BatteryMaximus/Dock-PCB/SingleCharger/SingleCharger.kicad_pcb

## KiCad design SingleCharger/SingleCharger.kicad_pcb (2025-04-10)

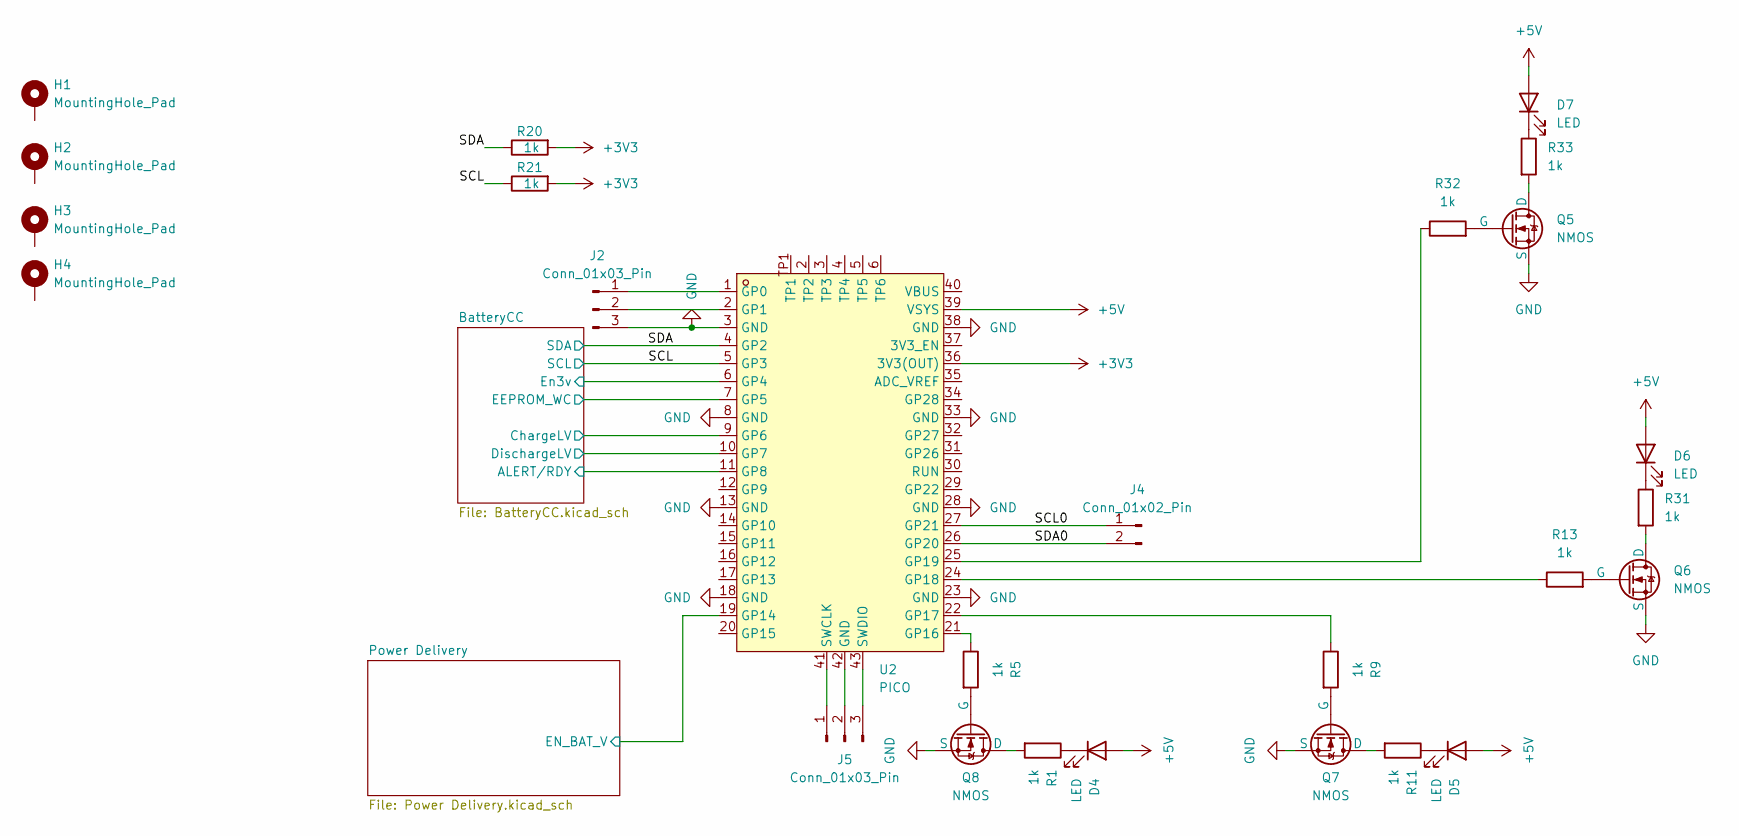
[picture p1: schematic SingleCharger.kicad_sch]

Parts:
D4, D5, D6, D7: LED; LED_1206_3216Metric
H1, H2, H3, H4: MountingHole_Pad; MountingHole_3.2mm_M3_DIN965_Pad_TopBottom
J2, J5: Conn_01x03_Pin; PinHeader_1x03_P2.54mm_Horizontal
J4: Conn_01x02_Pin; PinHeader_1x02_P2.54mm_Horizontal
Q5, Q6, Q7, Q8: NMOS; SOT-23
R1, R5, R9, R11, R13, R20, R21, R31, R32, R33: 1k; R_1206_3216Metric
U2: PICO; RaspberryPi_Pico_SMD; LCSC Part C7203002

Connections:
+3V3: R20.2, R21.2, U2.36 (3V3(OUT)); also elsewhere on the board
+5V: D4.2 (A), D5.2 (A), D6.2 (A), D7.2 (A), U2.39 (VSYS); also elsewhere on the board
/BatteryCC/ALERT/RDY: U2.11 (GP8); also elsewhere on the board
/BatteryCC/Battery/EEPROM_WC: U2.7 (GP5); also elsewhere on the board
/BatteryCC/ChargeLV: U2.9 (GP6); also elsewhere on the board
/DischargeLV: U2.10 (GP7)
/En3v: U2.6 (GP4)
/Power Delivery/EN_BAT_V: U2.19 (GP14); also elsewhere on the board
/SCL: R21.1, U2.5 (GP3); also elsewhere on the board
/SCL0: J4.1, U2.27 (GP21)
/SDA: R20.1, U2.4 (GP2); also elsewhere on the board
/SDA0: J4.2, U2.26 (GP20)
GND: J2.3, Q5.2 (S), Q6.2 (S), Q7.2 (S), Q8.2 (S), U2.3 (GND), U2.8 (GND), U2.13 (GND), U2.18 (GND), U2.23 (GND), U2.28 (GND), U2.33 (GND), U2.38 (GND); also elsewhere on the board
unnamed: D4.1 (K), R1.1
unnamed: D5.1 (K), R11.1
unnamed: D6.1 (K), R31.1
unnamed: D7.1 (K), R33.1
unnamed: J2.1, U2.1 (GP0)
unnamed: J2.2, U2.2 (GP1)
unnamed: J5.1, U2.41 (SWCLK)
unnamed: J5.2, U2.42 (GND)
unnamed: J5.3, U2.43 (SWDIO)
unnamed: Q5.3 (D), R33.2
unnamed: Q5.1 (G), R32.2
unnamed: Q6.3 (D), R31.2
unnamed: Q6.1 (G), R13.2
unnamed: Q7.3 (D), R11.2
unnamed: Q7.1 (G), R9.2
unnamed: Q8.3 (D), R1.2
unnamed: Q8.1 (G), R5.2
unnamed: R5.1, U2.21 (GP16)
unnamed: R9.1, U2.22 (GP17)
unnamed: R13.1, U2.24 (GP18)
unnamed: R32.1, U2.25 (GP19)

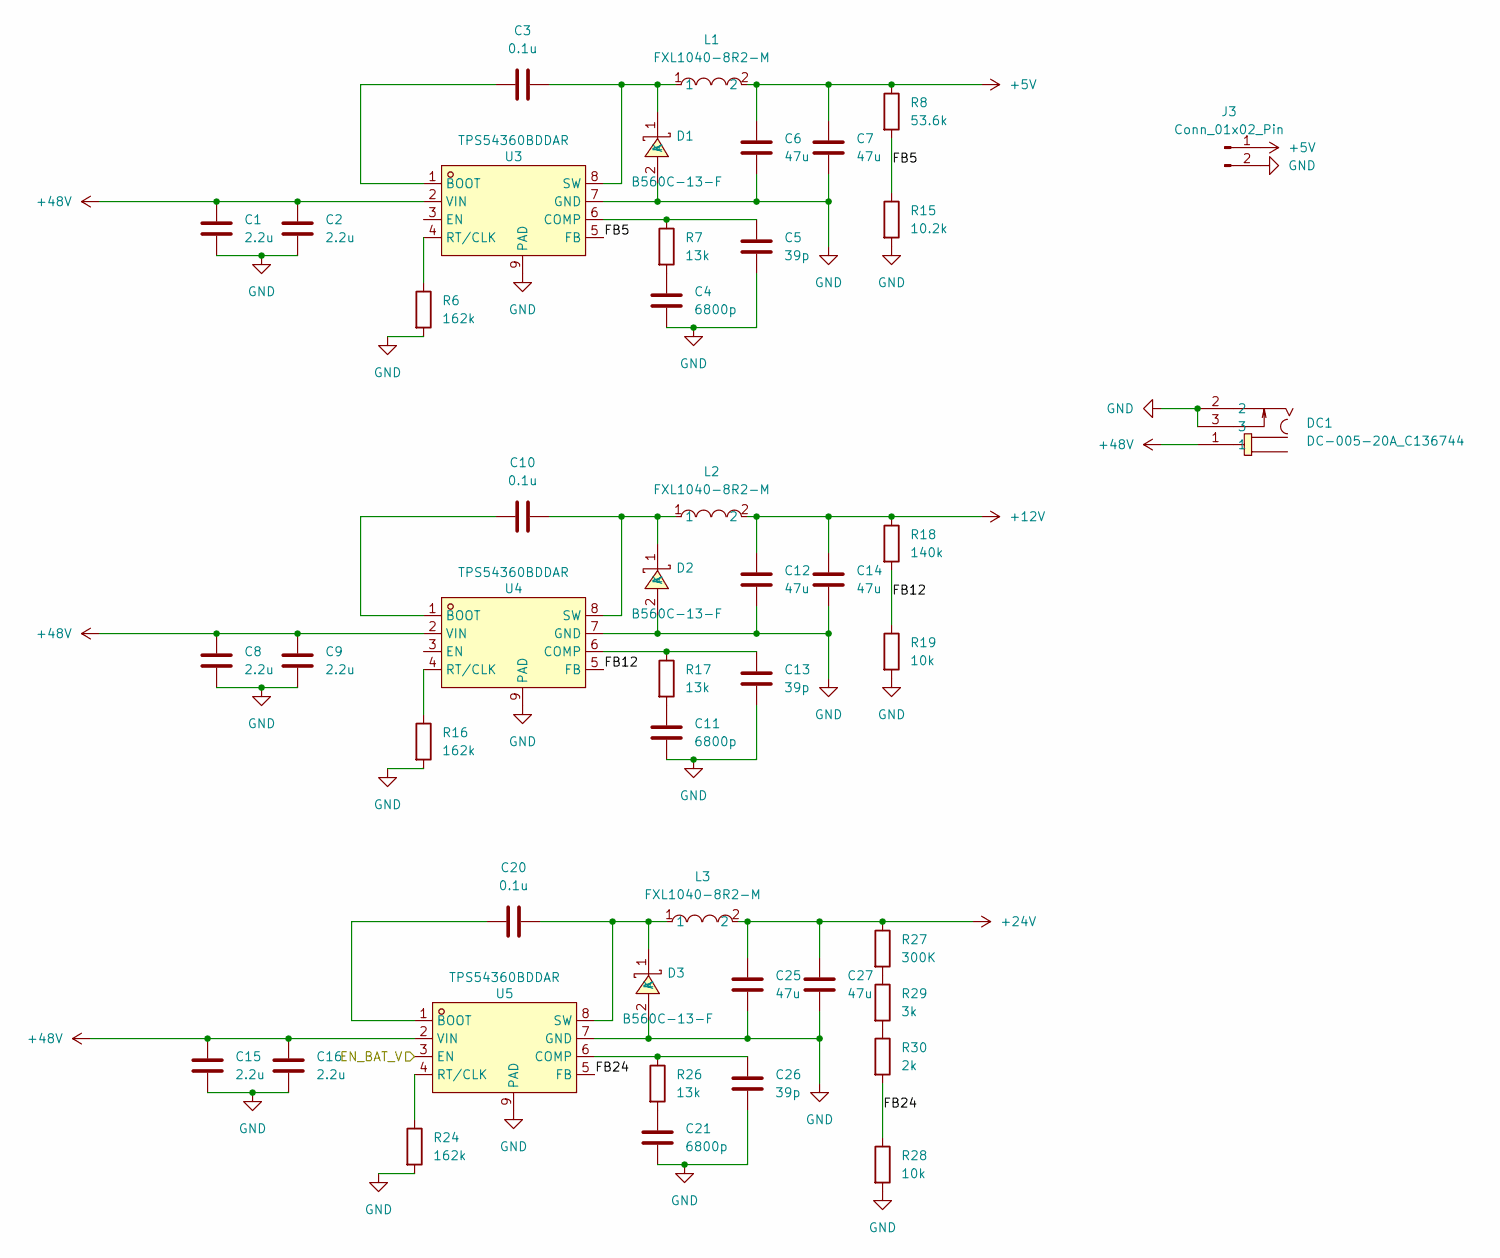
[picture p2: schematic Power Delivery.kicad_sch]

Parts:
C1, C2, C8, C9, C15, C16: 2.2u; C_1206_3216Metric; LCSC Part C170101
C3, C10, C20: 0.1u; C_1206_3216Metric; LCSC Part C56392
C4, C11, C21: 6800p; C_1206_3216Metric; LCSC Part C2760541
C5, C13, C26: 39p; C_1206_3216Metric; LCSC Part C5186878
C6, C7, C12, C14, C25, C27: 47u; C_1206_3216Metric; LCSC Part C94034
D1, D2, D3: B560C-13-F; SMC_L7.1-W6.2-LS8.1-RD; LCSC Part C85100
DC1: DC-005-20A_C136744; DC-IN-TH_DC-005-20A; LCSC Part C136744
J3: Conn_01x02_Pin; PinHeader_1x02_P2.54mm_Horizontal
L1, L2, L3: FXL1040-8R2-M; IND-SMD_L11.5-W10.0_FXL1040; LCSC Part C167232
R6, R16, R24: 162k; R_1206_3216Metric_Pad1.30x1.75mm_HandSolder; LCSC Part C22815
R7, R17, R26: 13k; R_1206_3216Metric_Pad1.30x1.75mm_HandSolder; LCSC Part C445658
R8: 53.6k; R_1206_3216Metric_Pad1.30x1.75mm_HandSolder; LCSC Part C21398
R15: 10.2k; R_1206_3216Metric_Pad1.30x1.75mm_HandSolder; LCSC Part C21398
R18: 140k; R_1206_3216Metric_Pad1.30x1.75mm_HandSolder; LCSC Part C21398
R19, R28: 10k; R_1206_3216Metric_Pad1.30x1.75mm_HandSolder; LCSC Part C21398
R27: 300K; R_1206_3216Metric_Pad1.30x1.75mm_HandSolder; LCSC Part C21398
R29: 3k; R_1206_3216Metric_Pad1.30x1.75mm_HandSolder; LCSC Part C21398
R30: 2k; R_1206_3216Metric_Pad1.30x1.75mm_HandSolder; LCSC Part C21398
U3, U4, U5: TPS54360BDDAR; SOIC-8_L5.0-W4.0-P1.27-LS6.0-BL-EP2.0; LCSC Part C524806

Connections:
+5V: C6.1, C7.1, J3.1, L1.2, R8.1; also elsewhere on the board
+12V: C12.1, C14.1, L2.2, R18.1; also elsewhere on the board
+24V: C25.1, C27.1, L3.2, R27.1; also elsewhere on the board
+48V: C1.1, C2.1, C8.1, C9.1, C15.1, C16.1, DC1.1, U3.2 (VIN), U4.2 (VIN), U5.2 (VIN)
/Power Delivery/EN_BAT_V: U5.3 (EN); also elsewhere on the board
/Power Delivery/FB5: R8.2, R15.1, U3.5 (FB)
/Power Delivery/FB12: R18.2, R19.1, U4.5 (FB)
/Power Delivery/FB24: R28.1, R30.2, U5.5 (FB)
GND: C1.2, C2.2, C4.2, C5.2, C6.2, C7.2, C8.2, C9.2, C11.2, C12.2, C13.2, C14.2, C15.2, C16.2, C21.2, C25.2, C26.2, C27.2, D1.2 (A), D2.2 (A), D3.2 (A), DC1.2, DC1.3, J3.2, R6.2, R15.2, R16.2, R19.2, R24.2, R28.2, U3.7 (GND), U3.9 (PAD), U4.7 (GND), U4.9 (PAD), U5.7 (GND), U5.9 (PAD); also elsewhere on the board
unnamed: C4.1, R7.2
unnamed: C11.1, R17.2
unnamed: C21.1, R26.2
unnamed: C3.2, D1.1 (K), L1.1, U3.8 (SW)
unnamed: C10.2, D2.1 (K), L2.1, U4.8 (SW)
unnamed: C20.2, D3.1 (K), L3.1, U5.8 (SW)
unnamed: R27.2, R29.1
unnamed: R29.2, R30.1
unnamed: C3.1, U3.1 (BOOT)
unnamed: C5.1, R7.1, U3.6 (COMP)
unnamed: R6.1, U3.4 (RT/CLK)
unnamed: C10.1, U4.1 (BOOT)
unnamed: C13.1, R17.1, U4.6 (COMP)
unnamed: R16.1, U4.4 (RT/CLK)
unnamed: C20.1, U5.1 (BOOT)
unnamed: C26.1, R26.1, U5.6 (COMP)
unnamed: R24.1, U5.4 (RT/CLK)

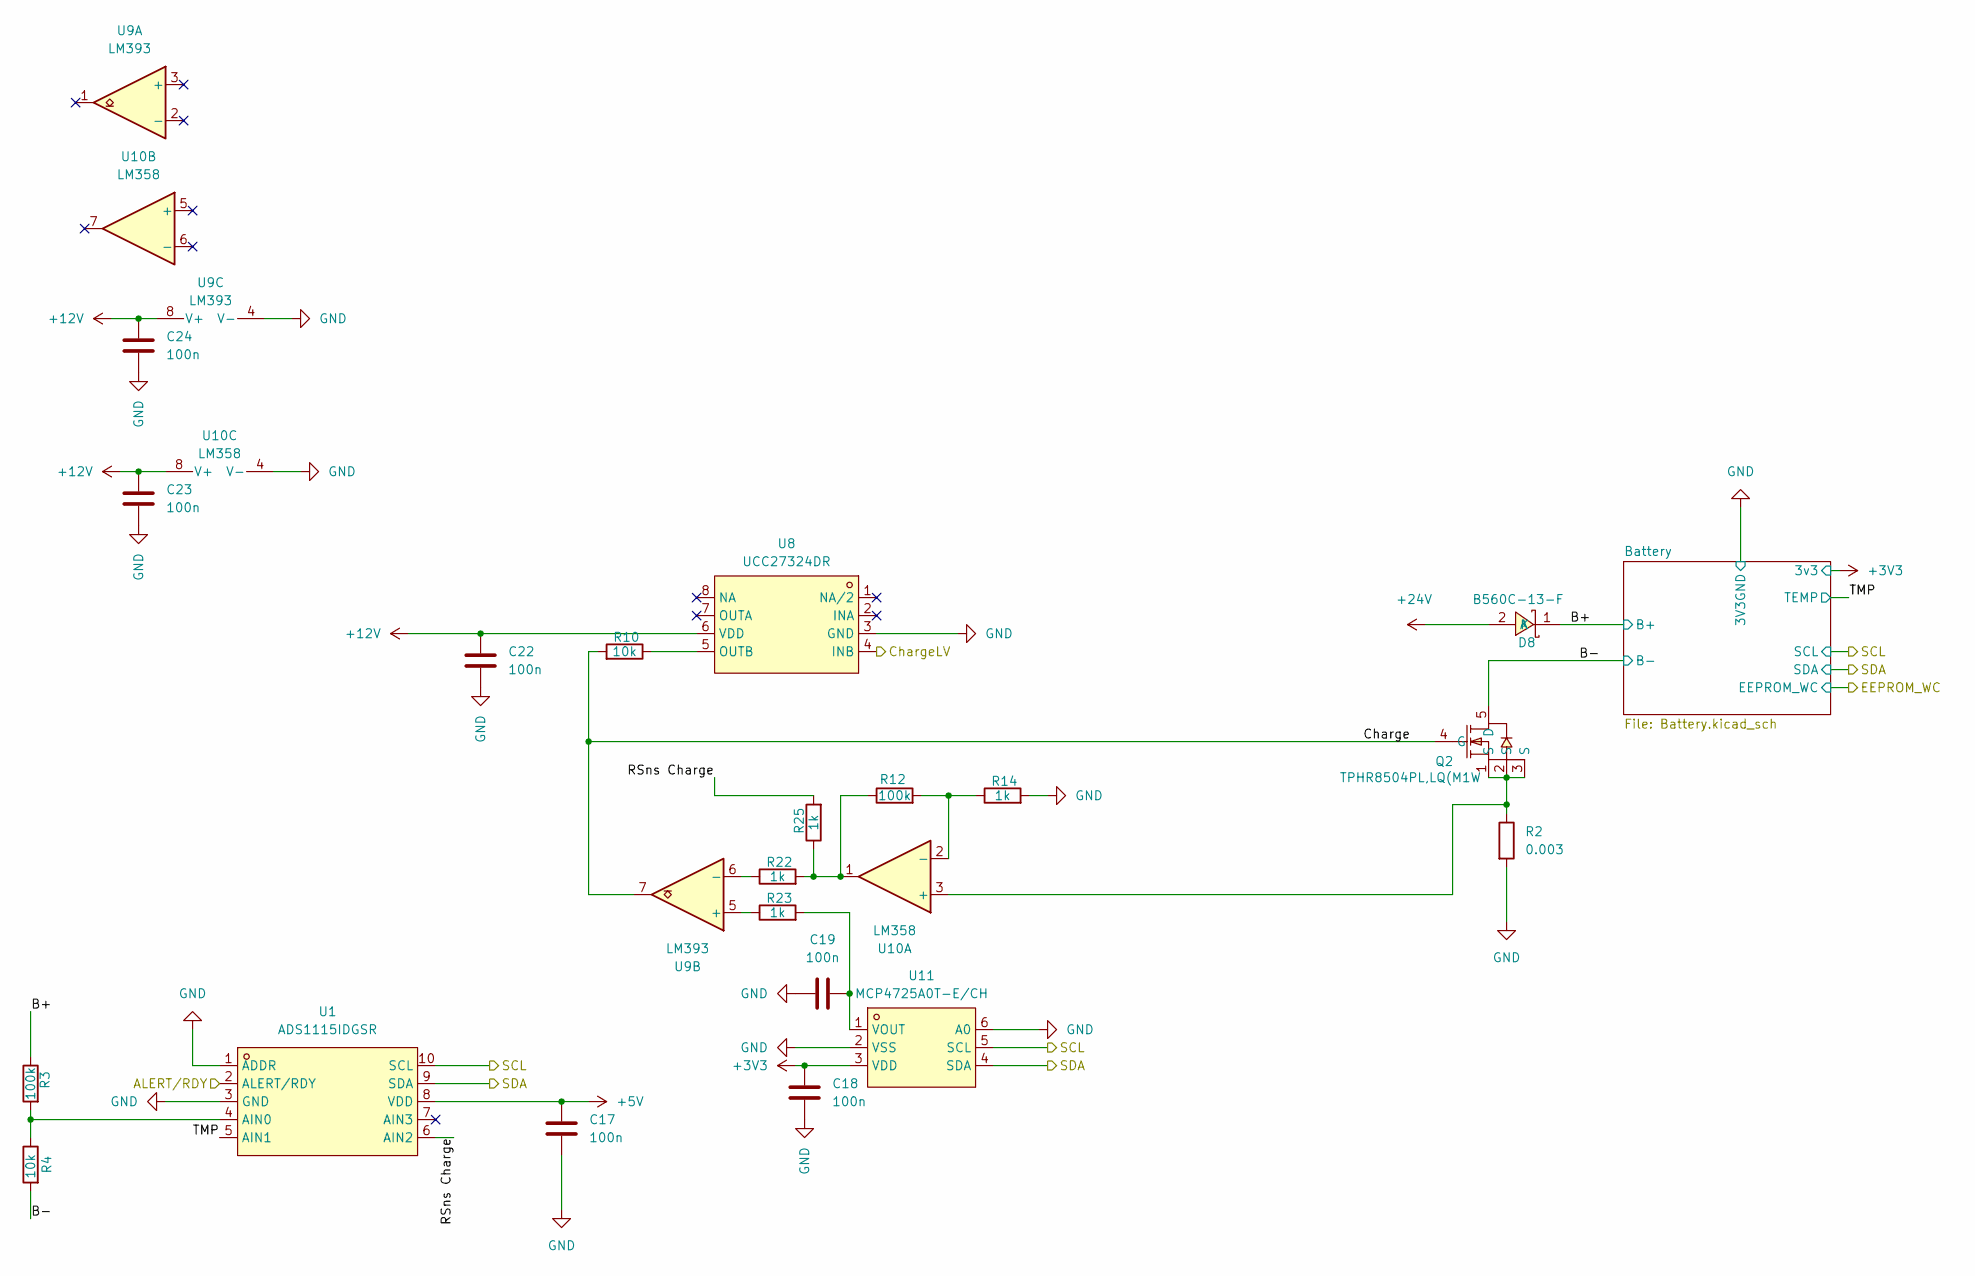
[picture p3: schematic BatteryCC.kicad_sch]

Parts:
C17, C18, C19, C22, C23, C24: 100n; R_1206_3216Metric_Pad1.30x1.75mm_HandSolder
D8: B560C-13-F; SMC_L7.1-W6.2-LS8.1-RD; LCSC Part C85100
Q2: TPHR8504PL,LQ(M1W; DFN-5_L4.9-W5.9-P1.27-LS6.2-BL; LCSC Part C22388172
R2: 0.003; R_1206_3216Metric_Pad1.30x1.75mm_HandSolder
R3, R12: 100k; R_1206_3216Metric_Pad1.30x1.75mm_HandSolder
R4, R10: 10k; R_1206_3216Metric_Pad1.30x1.75mm_HandSolder
R14, R22, R23, R25: 1k; R_1206_3216Metric
U1: ADS1115IDGSR; MSOP-10_L3.0-W3.0-P0.50-LS5.0-BL; LCSC Part C37593
U8: UCC27324DR; SOIC-8_L5.0-W4.0-P1.27-LS6.0-BL; LCSC Part C46427
U9: LM393; SOP-8_L4.9-W3.9-P1.27-LS6.0-BL
U10: LM358; SOP-8_L4.9-W3.9-P1.27-LS6.0-BL
U11: MCP4725A0T-E/CH; SOT-23-6_L2.9-W1.6-P0.95-LS2.8-BL; LCSC Part C144198

Connections:
+3V3: C18.1, U11.3 (VDD); also elsewhere on the board
+5V: C17.1, U1.8 (VDD); also elsewhere on the board
+12V: C22.1, C23.1, C24.1, U8.6 (VDD), U9.8 (V+), U10.8 (V+); also elsewhere on the board
+24V: D8.2 (A); also elsewhere on the board
/BatteryCC/ALERT/RDY: U1.2 (ALERT/RDY); also elsewhere on the board
/BatteryCC/B+: D8.1 (K), R3.1; also elsewhere on the board
/BatteryCC/B-: Q2.5 (D), R4.2; also elsewhere on the board
/BatteryCC/Charge: Q2.4 (G), R10.2, U9.7
/BatteryCC/ChargeLV: U8.4 (INB); also elsewhere on the board
/BatteryCC/RSns Charge: R25.2, U1.6 (AIN2)
/BatteryCC/TMP: U1.5 (AIN1); also elsewhere on the board
/SCL: U1.10 (SCL), U11.5 (SCL); also elsewhere on the board
/SDA: U1.9 (SDA), U11.4 (SDA); also elsewhere on the board
GND: C17.2, C18.2, C19.1, C22.2, C23.2, C24.2, R2.2, R14.2, U1.1 (ADDR), U1.3 (GND), U8.3 (GND), U9.4 (V-), U10.4 (V-), U11.2 (VSS), U11.6 (A0); also elsewhere on the board
unnamed: R12.1, R22.2, R25.1, U10.1
unnamed: R3.2, R4.1, U1.4 (AIN0)
unnamed: R10.1, U8.5 (OUTB)
unnamed: R23.1, U9.5 (+)
unnamed: R22.1, U9.6 (-)
unnamed: Q2.1 (S), Q2.2 (S), Q2.3 (S), R2.1, U10.3 (+)
unnamed: R12.2, R14.1, U10.2 (-)
unnamed: C19.2, R23.2, U11.1 (VOUT)

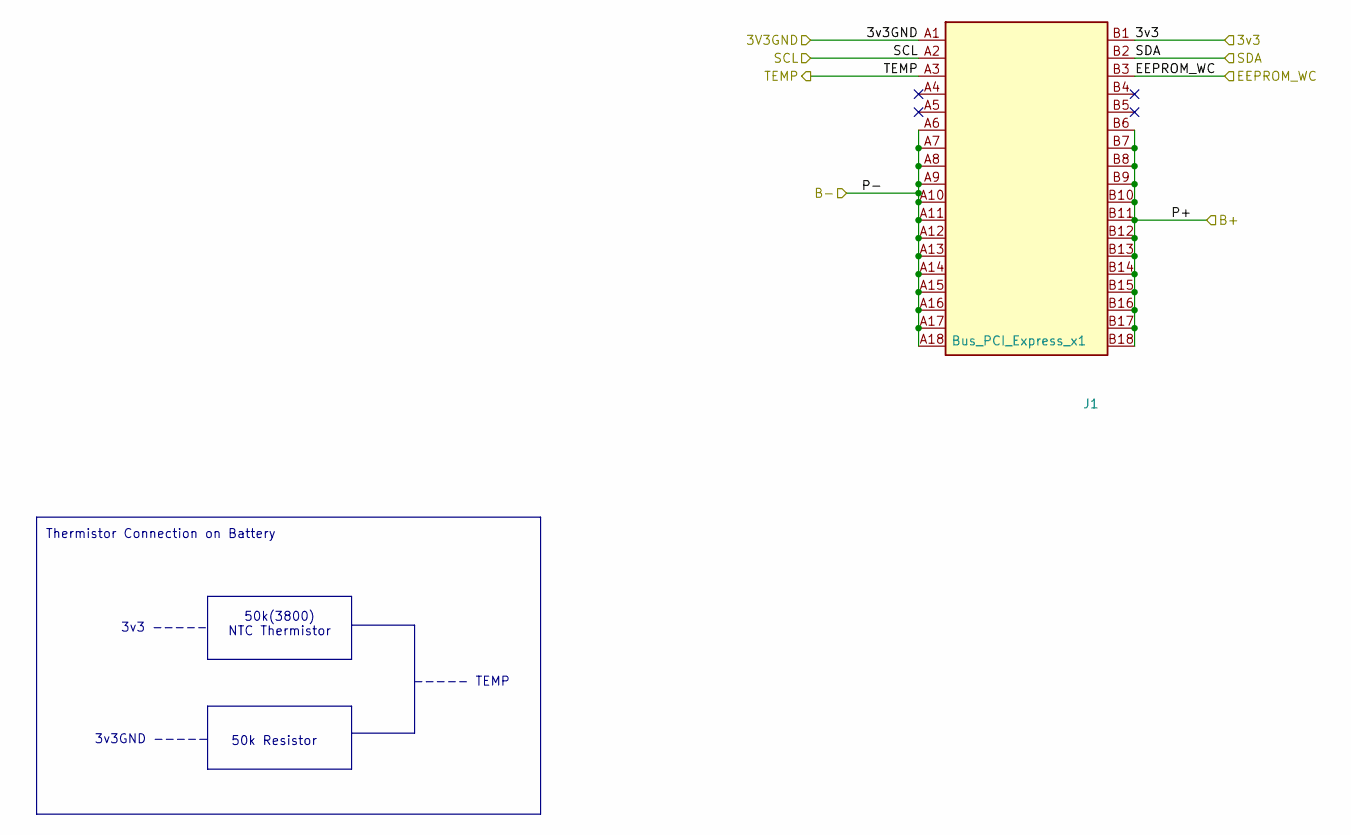
[picture p4: schematic Battery.kicad_sch, BatMax - Female]

Parts:
J1: Bus_PCI_Express_x1; CONN-TH_36P-P1.00-V_3183-XXXXXPXT

Connections:
+3V3: J1.B1; also elsewhere on the board
/BatteryCC/B+: J1.B6, J1.B7, J1.B8, J1.B9, J1.B10, J1.B11, J1.B12, J1.B13, J1.B14, J1.B15, J1.B16, J1.B17, J1.B18; also elsewhere on the board
/BatteryCC/B-: J1.A6, J1.A7, J1.A8, J1.A9, J1.A10, J1.A11, J1.A12, J1.A13, J1.A14, J1.A15, J1.A16, J1.A17, J1.A18; also elsewhere on the board
/BatteryCC/Battery/EEPROM_WC: J1.B3; also elsewhere on the board
/BatteryCC/TMP: J1.A3; also elsewhere on the board
/SCL: J1.A2; also elsewhere on the board
/SDA: J1.B2; also elsewhere on the board
GND: J1.A1; also elsewhere on the board

Notes on the sheet:
3v3 -----
----- TEMP
50k Resistor
3v3GND -----
50k(3800) NTC Thermistor
Thermistor Connection on Battery

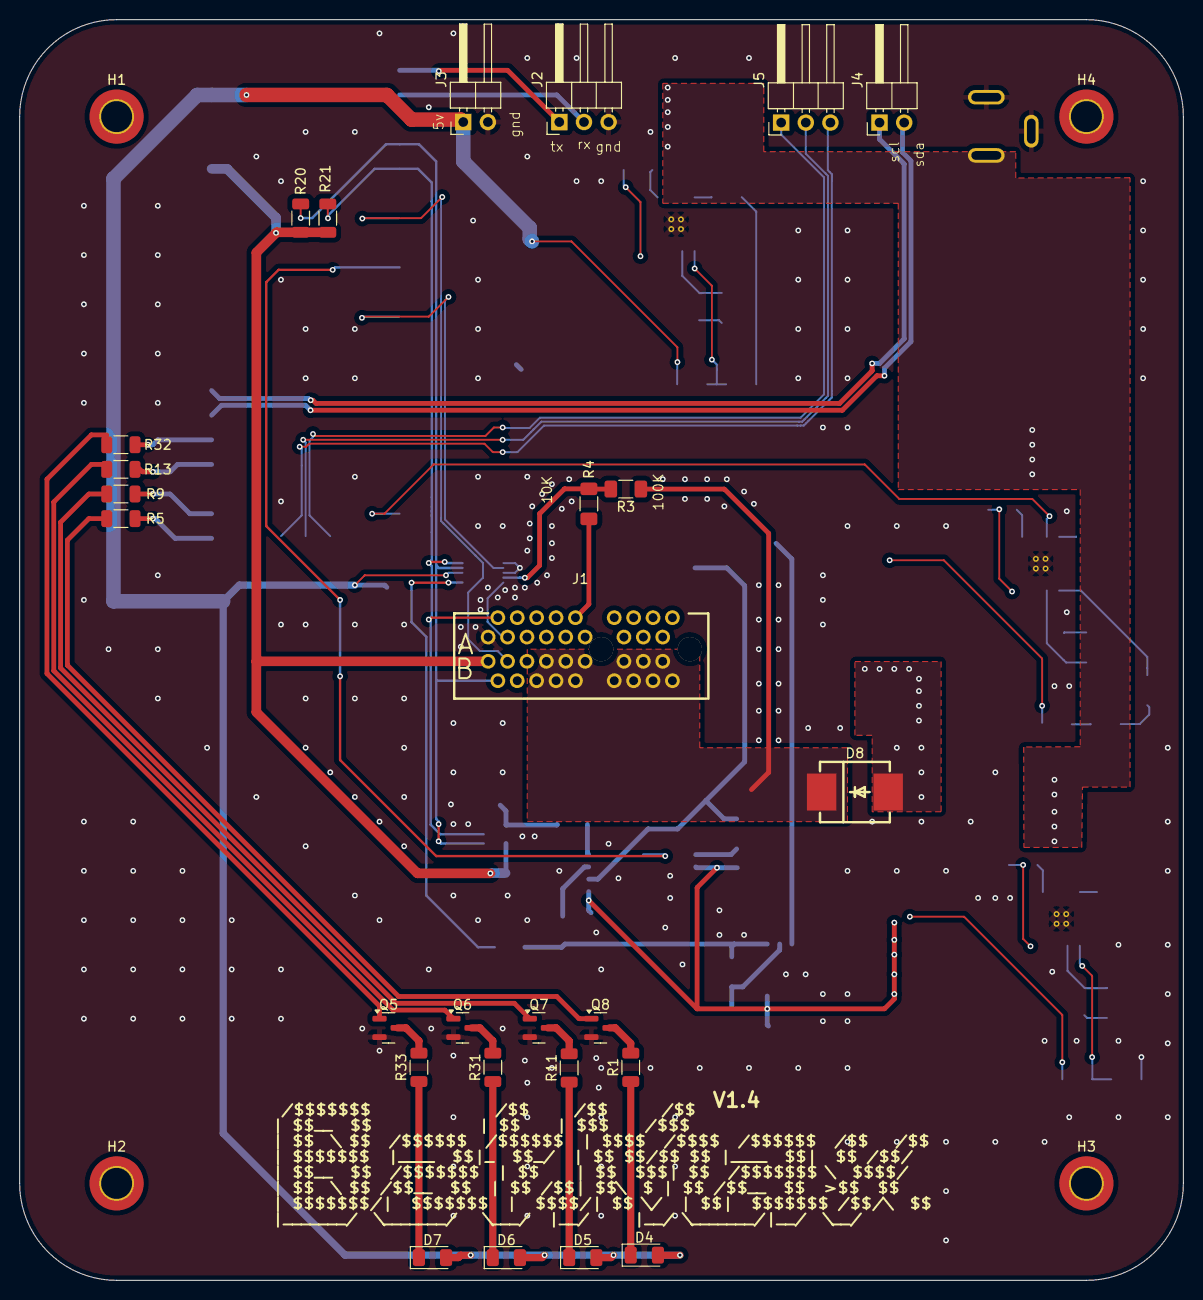
[picture p5: board SingleCharger.kicad_pcb from above]

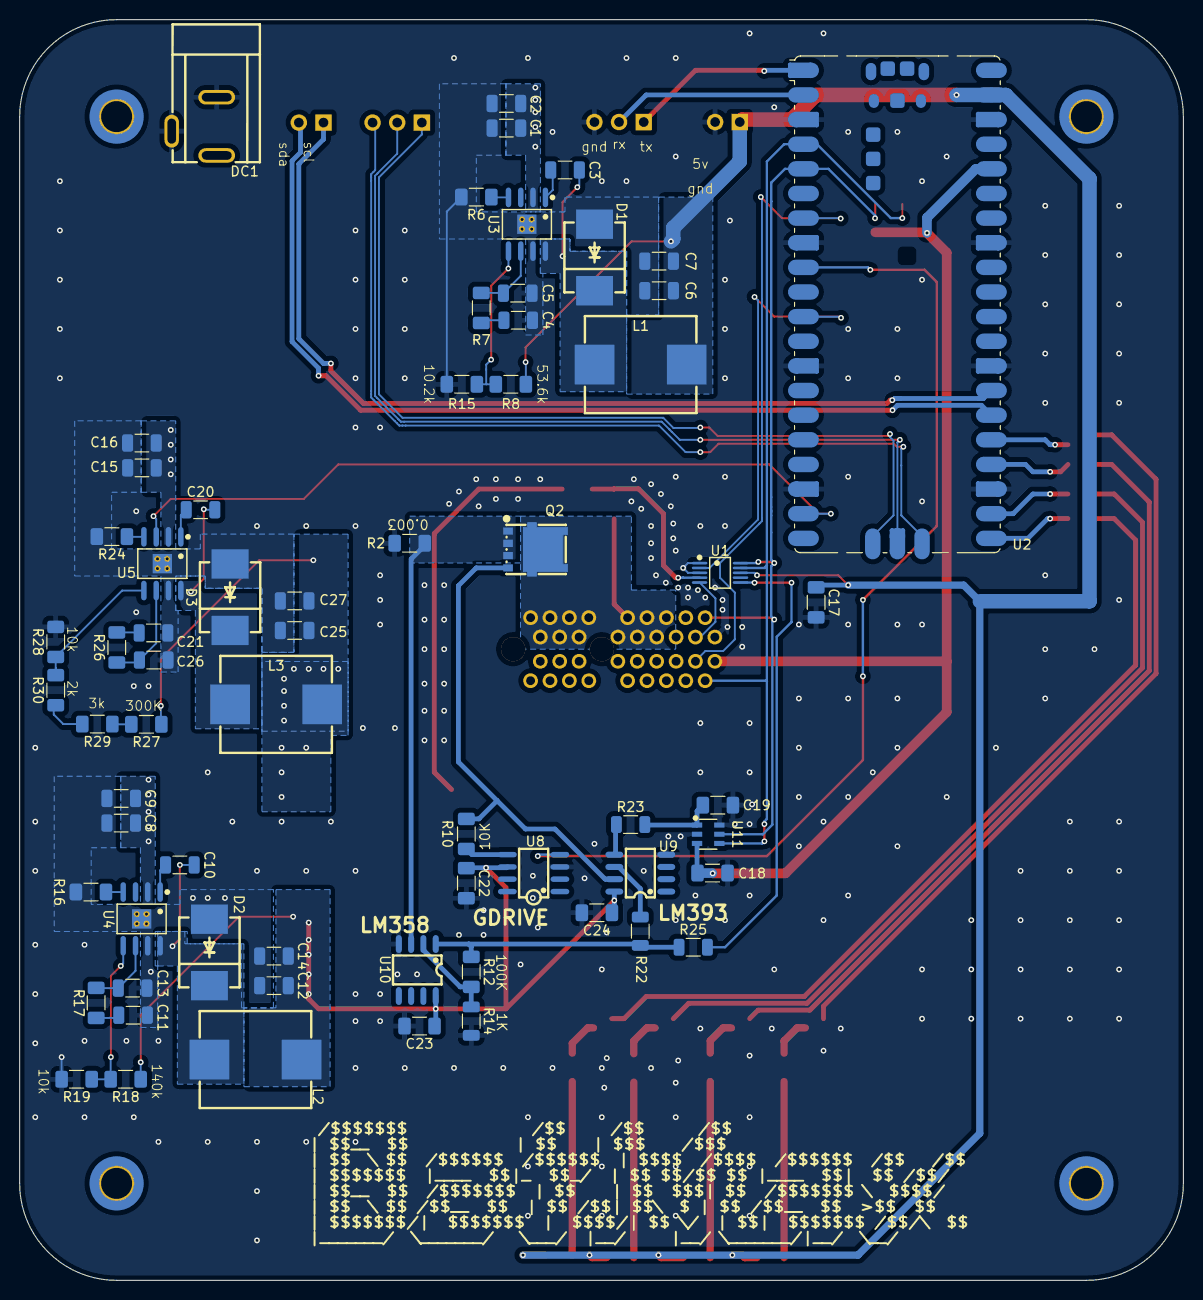
[picture p6: board SingleCharger.kicad_pcb from below]

Board: 4 copper layers, 120.0 x 130.0 mm, 95 parts (65 on the bottom side), 68 nets.
