BatteryMaximus/Dock-PCB/(commit log)

2025-03-31 First push.
    [Battery.kicad_sch, BatteryCC.kicad_sch, Power Delivery.kicad_sch, SingleCharger.kicad_pcb, SingleCharger.kicad_sch]
2025-04-01 Started adding LEDS
    [BatteryCC.kicad_sch, SingleCharger.kicad_pcb, SingleCharger.kicad_sch]
2025-04-01 Added LEDS.
    [SingleCharger.kicad_pcb]
2025-04-01 Working on fixing PICO.
    [SingleCharger.kicad_pcb, SingleCharger.kicad_sch]
2025-04-01 Finished with layout changes.
    [Power Delivery.kicad_sch, SingleCharger.kicad_pcb, SingleCharger.kicad_sch]
2025-04-01 Updated Silkscreen
    [SingleCharger.kicad_pcb]
2025-04-10 Fixed some issues for hopeful stability in analog measuremnets.
    [BatteryCC.kicad_sch, SingleCharger.kicad_pcb]
2025-04-10 Fixed silkscreen.
    [SingleCharger.kicad_pcb]
